erik-rosen/pid-controller/README.md

# Boat Engine Governor

A closed-loop electronic throttle governor for a small marine engine, built on a Raspberry Pi Pico.

Governor in action

## Why this exists

Small marine engines have a throttle backstop screw that sets the minimum idle position. The problem is that the right backstop setting changes with engine temperature:

- **Cold engine:** Needs more throttle to idle without stalling, so the backstop is set higher
- **Hot engine in neutral:** The same backstop position causes the engine to race at high RPMs
- **Hot engine in gear:** The backstop prevents the throttle from closing far enough to run at low RPMs for docking

There's no single backstop position that works for all conditions. This governor solves the problem by replacing the fixed backstop with closed-loop RPM control. The backstop screw is set low enough for hot-engine operation, and the controller adds throttle as needed to prevent stalling when the engine is cold or under load.

## What it does

Maintains a target engine RPM by automatically adjusting the throttle via an RC servo and Bowden cable. A potentiometer sets the desired RPM (530–2500), and a toggle switch selects between manual throttle control and automatic closed-loop mode. The critical operating range is low RPM (530–800) during docking maneuvers where the margin between stalling and racing is smallest.

## Hardware

- **MCU:** Raspberry Pi Pico / Pico W (RP2040)
- **Throttle actuator:** 20 kg RC servo with Bowden cable linkage
- **RPM sensor:** NJK inductive sensor (4 pulses/rev) with optocoupler isolation

NJK sensor mounted on bracket, sensing flywheel magnets
  
- **Power:** 12V boat electrical system via XL4015 buck converter (~5.1V out)
- **Controls:** Potentiometer (GP26), manual/auto toggle switch (GP16)

### Pin assignments

| Function | GPIO | Physical pin |
|---|---|---|
| Servo PWM | GP15 | 20 |
| Mode switch | GP16 | 21 |
| RPM sensor | GP22 | 29 |
| Potentiometer | GP26 (ADC0) | 31 |
| Status LED | GP25 | onboard |

## Control strategy

- **Feed-forward table** maps target RPM to an approximate servo position
- **PI controller** corrects the remaining error (Kp = 0.3)
- **Adaptive FF offset** slowly shifts the feed-forward curve to compensate for load changes (in gear, wind, current)
- **Watchdog timer** (500ms) reboots the Pico if the loop ever hangs

## Servo calibration

The servo range is calibrated to the physical throttle linkage:
- 1072 us = throttle fully closed
- 1732 us = throttle fully open

## Helper sketches

- **`servo-calibrate/`** — Step through servo positions with spacebar to find mechanical limits
- **`servo-sweep/`** — Continuously sweep the servo across its full range for testing

## Building

Open `pid-controller.ino` in the Arduino IDE with the [Arduino-Pico core](https://github.com/earlephilhower/arduino-pico) installed. Select "Raspberry Pi Pico" as the board and upload.

## License

MIT
