erik-rosen/pid-controller/(commit log)

2026-05-14 Tune PID controller for Bowden cable linkage and add safety features
    - Calibrate servo limits to actual throttle range (1072-1732 µs)
    - Reduce Kp from 1.5 to 0.3 to eliminate oscillation
    - Update feed-forward table with measured idle point and linear placeholder
    - Set minimum target RPM to 530 to avoid stalling
    - Add watchdog timer (500ms) to reboot on hang
    - Guard serial output to prevent blocking when USB disconnects
    - Add servo calibration and sweep helper sketches
    [pid-controller.ino, servo-calibrate.ino, servo-sweep.ino]
2026-05-14 Document the throttle backstop problem and critical operating range
    The governor exists because no single backstop screw position works
    across cold/hot engine and neutral/in-gear conditions. Added context
    to both README and AGENTS.md.
2026-05-15 Real engine mapping and adaptive state reset on target changes
    - Feed-forward table from actual engine data at ~40°C coolant temp
    (530-2500 RPM, 7 data points measured in neutral)
    - Reset FF offset and I-term when target RPM changes >200 RPM
    within a 2-second window to prevent stale state during
    cruise-to-idle transitions
    - Fix serial guard that was blocking all output
    - Clear watchdog on startup to prevent reboot loops
    [pid-controller.ino]
2026-05-17 Add photo of NJK sensor bracket on flywheel
