erik-rosen/pid-controller/rpm-njk.jpeg

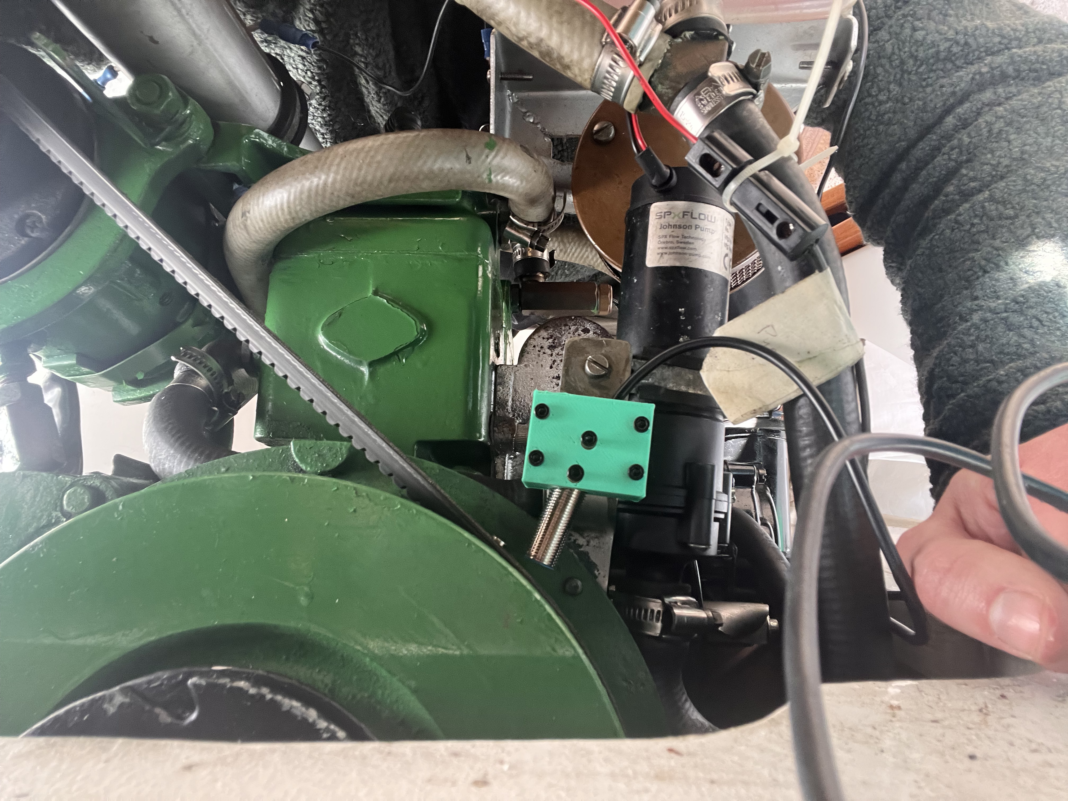
[picture p1: rpm-njk.jpeg]
rpm-njk.jpeg
